freddie-renyard/frugal6502/schematic/Schematic_Rev1.0.png

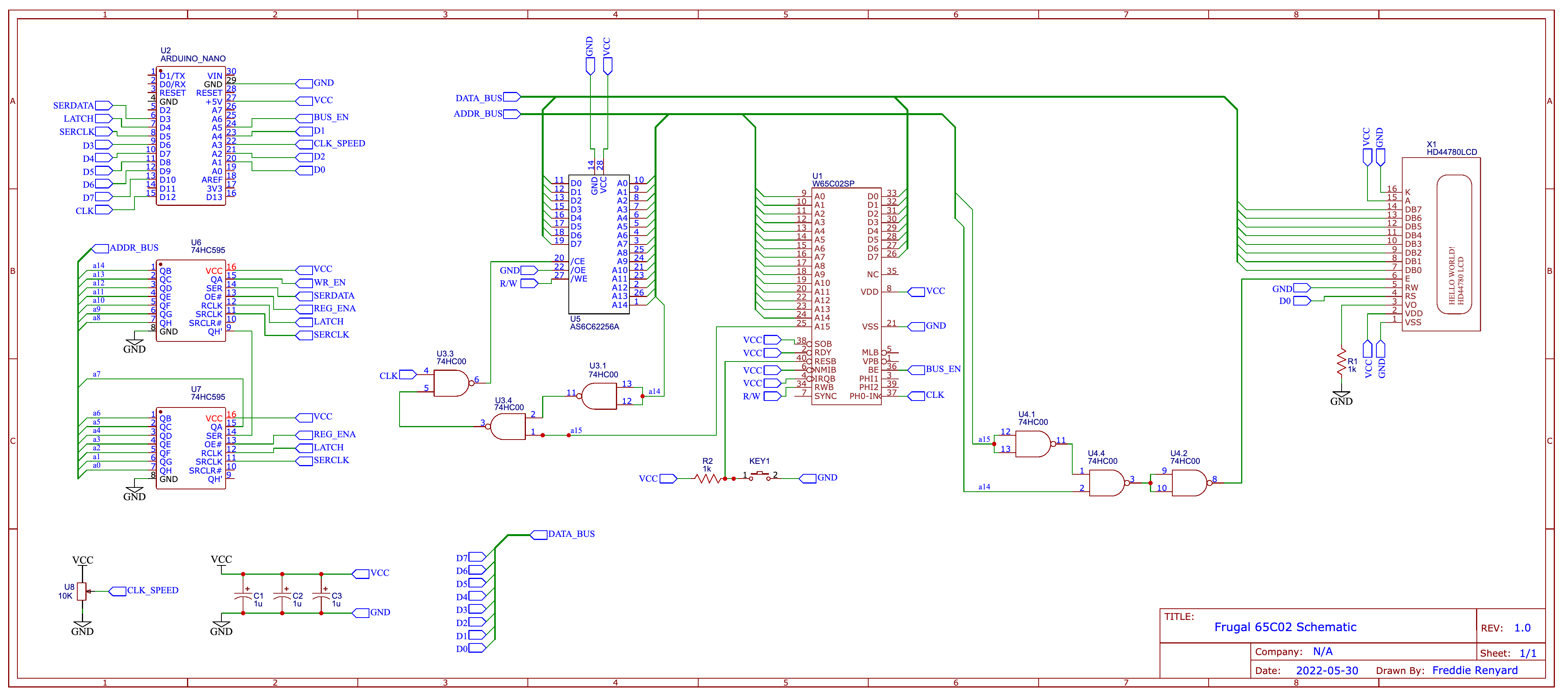
schematic/Schematic_Rev1.0.png
