freddie-renyard/frugal6502/(commit log)

2022-06-02 Added more comments to the binary search assembly
2022-06-02 Started assembly calculator project
2022-06-04 Added circuit schematic
2022-06-04 Added schematic image to README
2022-06-04 Updated error in schematic
